Kampi/LoRa-GPS-Tracker/docs/images/Image_Complete.png

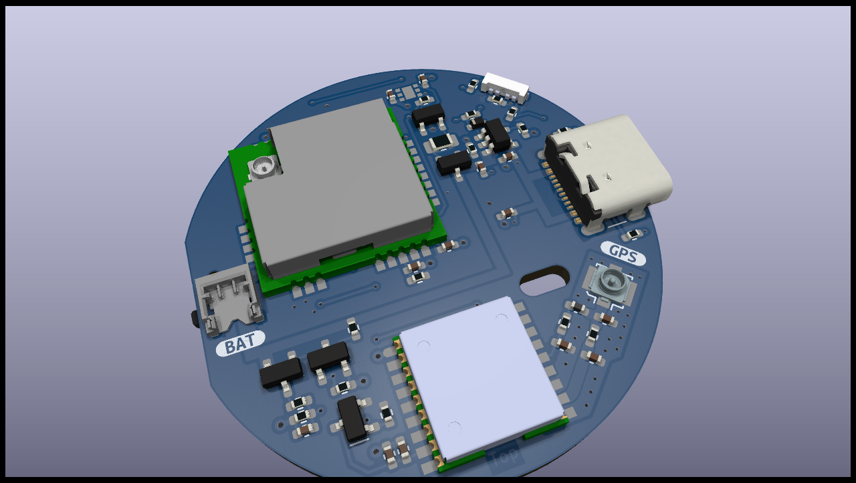
docs/images/Image_Complete.png
