Kampi/LoRa-GPS-Tracker/CHANGELOG.md

# CHANGELOG

## [1.0.0] - 

- Initial release
