Kampi/LoRa-GPS-Tracker/(threads)

Thread 7 (2024-02-12):

Replace micro USB connector with USB C

Kampi, 2024-02-12:

Closed 2024-02-12.
