Kampi/LoRa-GPS-Tracker/project/LoRa-GPS-Tracker.kicad_pcb

## KiCad design project/LoRa-GPS-Tracker.kicad_pcb (2024-10-27)

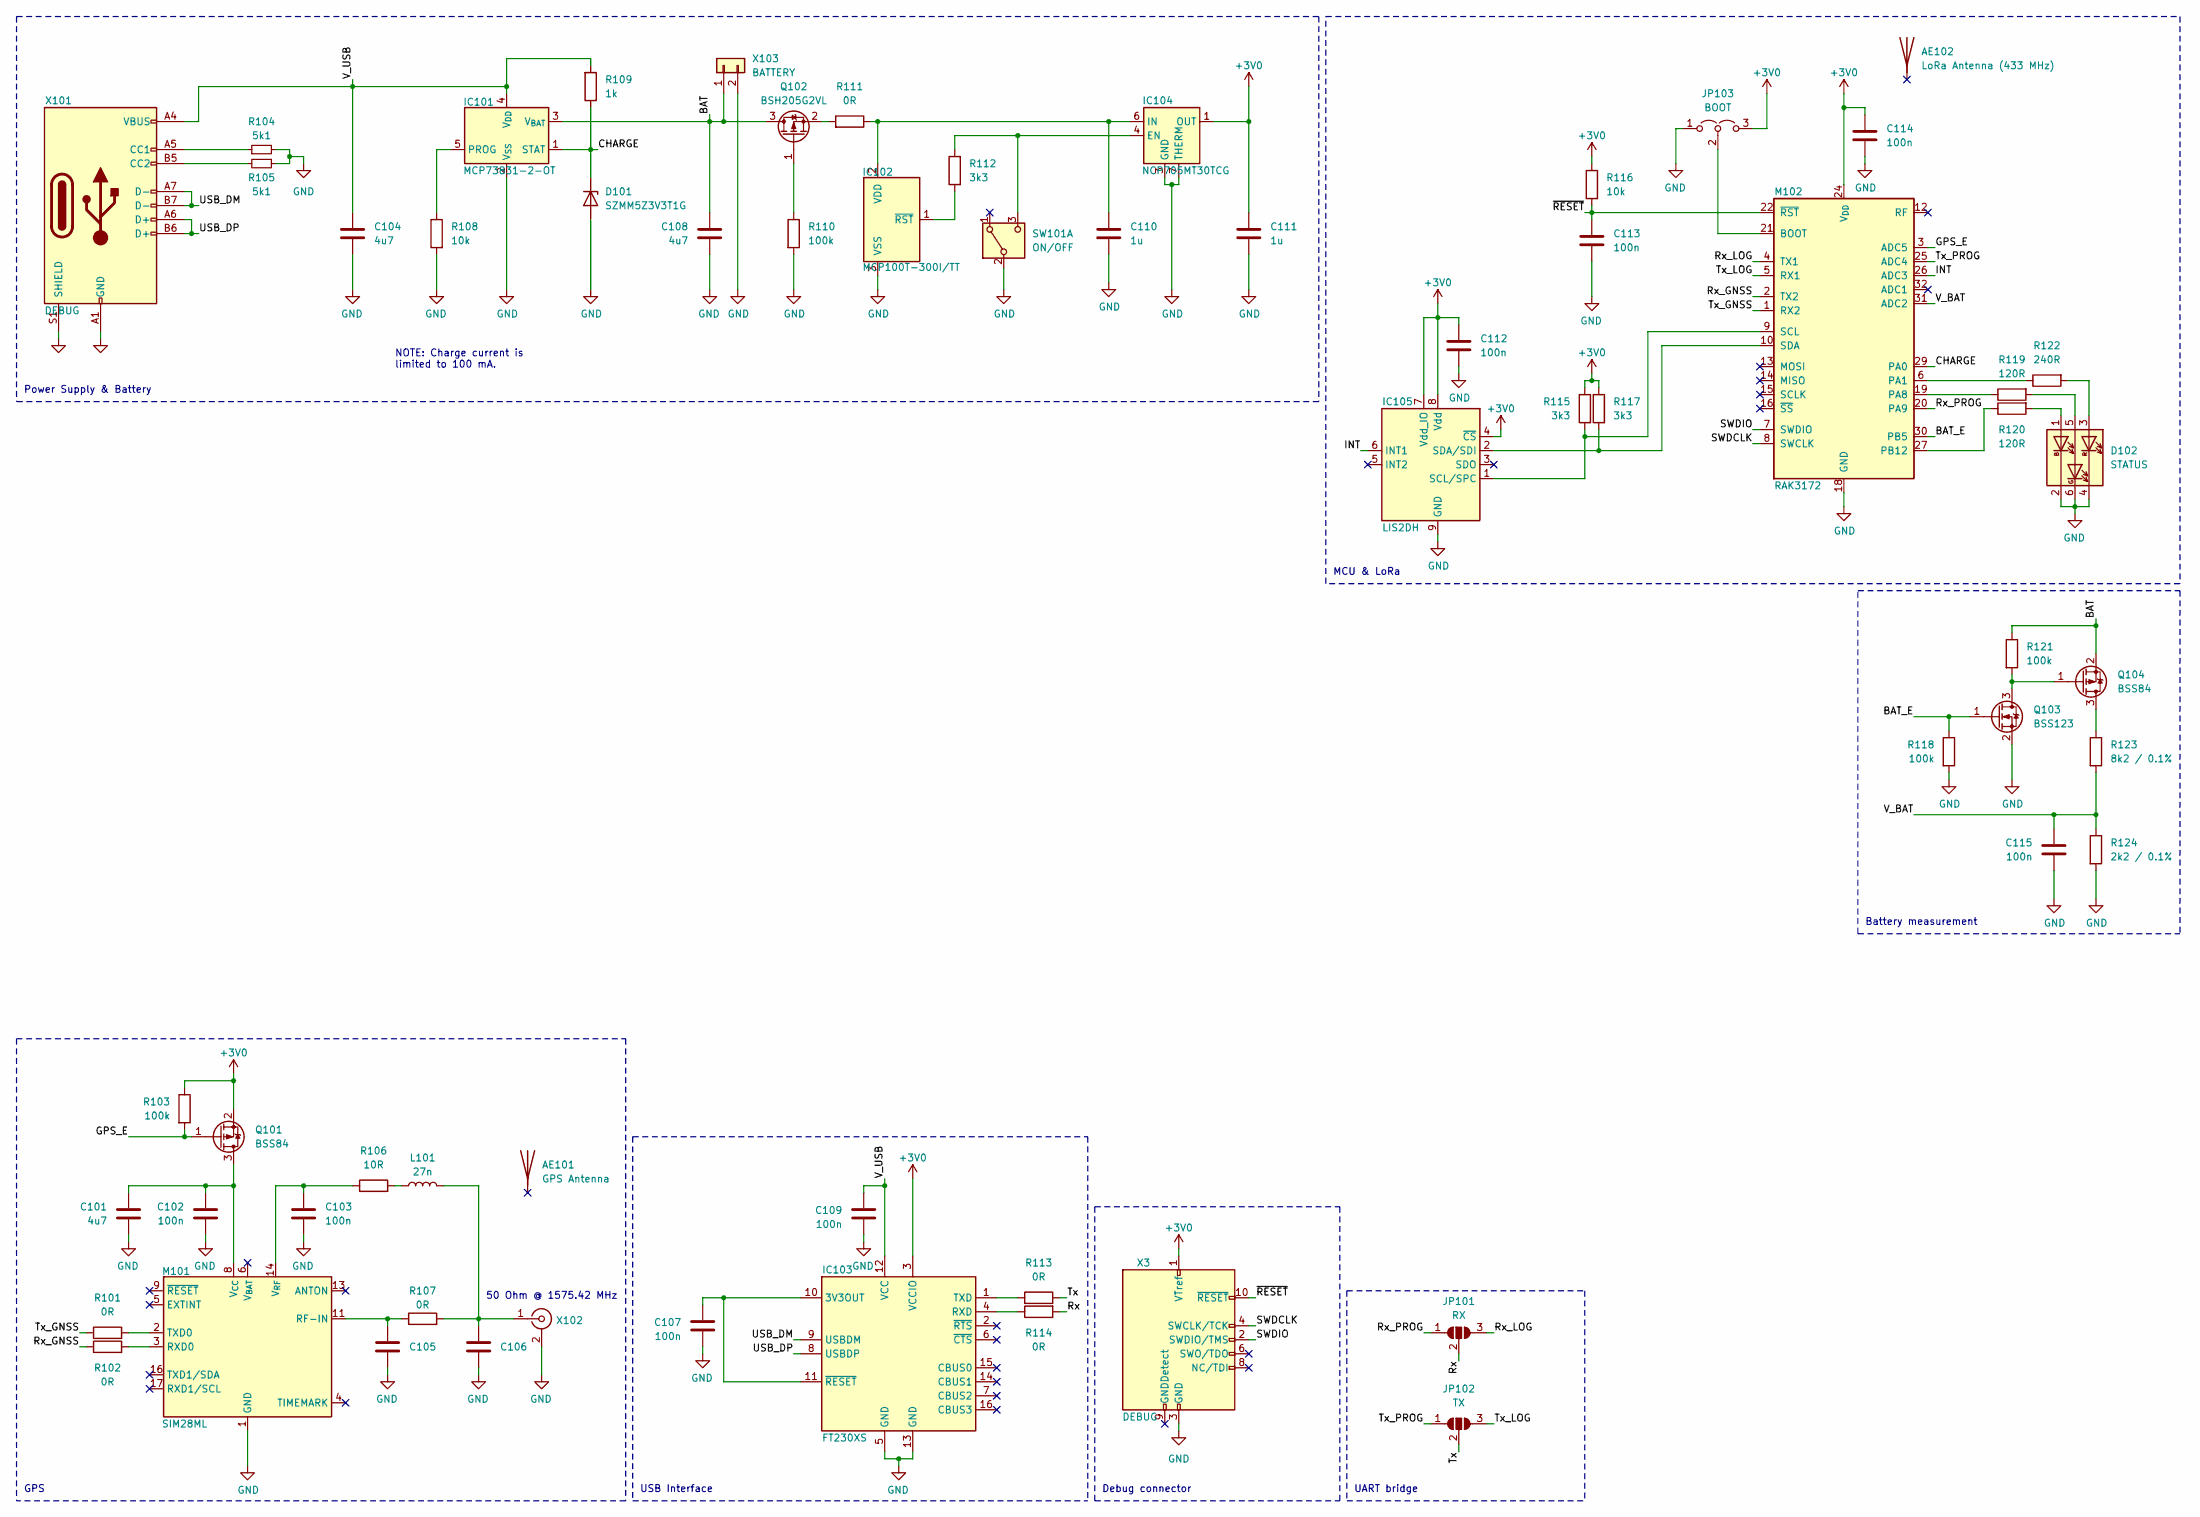
[picture p4: schematic LoRa-GPS-Tracker.kicad_sch]

Parts:
AE101: GPS Antenna
AE102: LoRa Antenna (433 MHz)
C101, C104, C108: 4u7; C_0402_1005Metric_Pad0.74x0.62mm_HandSolder
C102, C103, C107, C109, C112, C113, C114, C115: 100n; C_0402_1005Metric_Pad0.74x0.62mm_HandSolder
C105, C106: C_0402_1005Metric_Pad0.74x0.62mm_HandSolder
C110, C111: 1u; C_0402_1005Metric_Pad0.74x0.62mm_HandSolder
D101: SZMM5Z3V3T1G; D_SOD-523
D102: STATUS; QLS6B-FKW-CNSNSF043
IC101: MCP73831-2-OT; SOT-23-5
IC102: MCP100T-300I/TT; SOT-23
IC103: FT230XS; SSOP-16_3.9x4.9mm_P0.635mm
IC104: NCP705MT30TCG; WDFN-6
IC105: LIS2DH; LGA-14_2x2mm_P0.35mm_LayoutBorder3x4y
JP101: RX; SolderJumper-3_P1.3mm_Open_RoundedPad1.0x1.5mm_NumberLabels
JP102: TX; SolderJumper-3_P1.3mm_Open_RoundedPad1.0x1.5mm_NumberLabels
JP103: BOOT; SolderJumper-3_P1.3mm_Open_RoundedPad1.0x1.5mm_NumberLabels
L101: 27n; L_0402_1005Metric_Pad0.77x0.64mm_HandSolder
M101: SIM28ML
M102: RAK3172
Q101, Q104: BSS84; SOT-23
Q102: BSH205G2VL; SOT-23
Q103: BSS123; SOT-23
R101, R102, R107, R113, R114: 0R; R_0402_1005Metric_Pad0.72x0.64mm_HandSolder
R103, R110, R118, R121: 100k; R_0402_1005Metric_Pad0.72x0.64mm_HandSolder
R104, R105: 5k1; R_0402_1005Metric_Pad0.72x0.64mm_HandSolder
R106: 10R; R_0402_1005Metric_Pad0.72x0.64mm_HandSolder
R108, R116: 10k; R_0402_1005Metric_Pad0.72x0.64mm_HandSolder
R109: 1k; R_0402_1005Metric_Pad0.72x0.64mm_HandSolder
R111: 0R; R_0805_2012Metric_Pad1.20x1.40mm_HandSolder
R112, R115, R117: 3k3; R_0402_1005Metric_Pad0.72x0.64mm_HandSolder
R119, R120: 120R; R_0402_1005Metric_Pad0.72x0.64mm_HandSolder
R122: 240R; R_0402_1005Metric_Pad0.72x0.64mm_HandSolder
R123: 8k2 / 0.1%; R_0402_1005Metric_Pad0.72x0.64mm_HandSolder
R124: 2k2 / 0.1%; R_0402_1005Metric_Pad0.72x0.64mm_HandSolder
SW101: ON/OFF; SW_SPDT_PCM12
X3: DEBUG; SHF-105-01-L-D-SM-TR
X101: DEBUG; USB_C_Receptacle_GCT_USB4105-xx-A_16P_TopMnt_Horizontal
X102: Conn_Coaxial; 73412-0110
X103: BATTERY; 78171-0002

Connections:
+3V0: C111.1, C112.1, C114.1, IC103.3 (VCCIO), IC104.1 (OUT), IC105.4 (~CS), IC105.7 (Vdd_IO), IC105.8 (Vdd), JP103.3 (B), M102.24 (VDD), Q101.2 (S), R103.1, R115.1, R116.1, R117.1; also elsewhere on the board
/BAT: C108.1, IC101.3 (V_{BAT}), Q102.3 (D), Q104.2 (S), R121.1, X103.1
/BAT_E: M102.30 (PB5), Q103.1 (G), R118.1
/CHARGE: D101.1 (K), IC101.1 (STAT), M102.29 (PA0), R109.1
/GPS_E: M102.3 (ADC5), Q101.1 (G), R103.2
/INT: IC105.6 (INT1), M102.26 (ADC3)
/Rx: JP101.2 (C), R114.2
/Rx_GNSS: M102.2 (TX2), R102.1
/Rx_LOG: JP101.3 (B), M102.4 (TX1)
/Rx_PROG: JP101.1 (A), M102.20 (PA9)
/SWDCLK: M102.8 (SWCLK); also elsewhere on the board
/SWDIO: M102.7 (SWDIO); also elsewhere on the board
/Tx: JP102.2 (C), R113.1
/Tx_GNSS: M102.1 (RX2), R101.1
/Tx_LOG: JP102.3 (B), M102.5 (RX1)
/Tx_PROG: JP102.1 (A), M102.25 (ADC4)
/USB_DM: IC103.9 (USBDM), X101.A7 (D-), X101.B7 (D-)
/USB_DP: IC103.8 (USBDP), X101.A6 (D+), X101.B6 (D+)
/V_BAT: C115.1, M102.31 (ADC1), R123.2, R124.1
/V_USB: C104.1, C109.1, IC101.4 (V_{DD}), IC103.12 (VCC), R109.2, X101.A4 (VBUS), X101.A9 (VBUS), X101.B4 (VBUS), X101.B9 (VBUS)
/~RESET: C113.1, M102.22 (~RST), R116.2; also elsewhere on the board
GND: C101.2, C102.2, C103.2, C104.2, C105.2, C106.2, C107.2, C108.2, C109.2, C110.2, C111.2, C112.2, C113.2, C114.2, C115.2, D101.2 (A), D102.2 (KB), D102.4 (KR), D102.6 (KR), IC101.2 (V_{SS}), IC102.3 (VSS), IC103.5 (GND), IC103.13 (GND), IC104.3 (GND), IC104.7 (THERM), IC105.9 (GND), IC105.10 (GND), IC105.11 (GND), IC105.12 (GND), IC105.13 (GND), IC105.14 (GND), JP103.1 (A), M101.1 (GND), M101.10 (GND), M101.12 (GND), M102.11 (VSS), M102.17 (VSS), M102.18 (VSS), M102.23 (VSS), M102.28 (VSS), Q103.2 (S), R104.2, R105.1, R108.2, R110.2, R118.2, R124.2, SW101.2 (B), X101.A1 (GND), X101.A12 (GND), X101.B1 (GND), X101.B12 (GND), X101.S1 (SHIELD), X102.2 (Ext), X103.2; also elsewhere on the board
unnamed: D102.1 (AB), R120.2
unnamed: D102.5 (AG), R119.2
unnamed: D102.3 (AR), R122.2
unnamed: IC101.5 (PROG), R108.1
unnamed: C110.1, IC102.2 (VDD), IC104.6 (IN), R111.1
unnamed: IC102.1 (~RST), R112.2
unnamed: C107.1, IC103.10 (3V3OUT), IC103.11 (~RESET)
unnamed: IC103.4 (RXD), R114.1
unnamed: IC103.1 (TXD), R113.2
unnamed: IC104.4 (EN), R112.1, SW101.3 (C)
unnamed: IC105.1 (SCL/SPC), M102.9 (SCL), R115.2
unnamed: IC105.2 (SDA/SDI), M102.10 (SDA), R117.2
unnamed: JP103.2 (C), M102.21 (BOOT)
unnamed: L101.1, R106.2
unnamed: C105.1, M101.11 (RF_IN), R107.1
unnamed: M101.3 (RXD0), R102.2
unnamed: M101.2 (TXD0), R101.2
unnamed: C101.1, C102.1, M101.8 (VCC), Q101.3 (D)
unnamed: C103.1, M101.14 (VCC_RF), R106.1
unnamed: M102.6 (PA1), R122.1
unnamed: M102.19 (PA8), R119.1
unnamed: M102.27 (PB12), R120.1
unnamed: Q102.1 (G), R110.1
unnamed: Q102.2 (S), R111.2
unnamed: Q103.3 (D), Q104.1 (G), R121.2
unnamed: Q104.3 (D), R123.1
unnamed: R104.1, X101.A5 (CC1)
unnamed: R105.2, X101.B5 (CC2)
unnamed: C106.1, L101.2, R107.2, X102.1 (In)

Notes on the sheet:
Debug connector
GPS
USB Interface
UART bridge
50 Ohm @ 1575.42 MHz
Battery measurement
Power Supply & Battery
NOTE: Charge current is limited to 100 mA.
MCU & LoRa

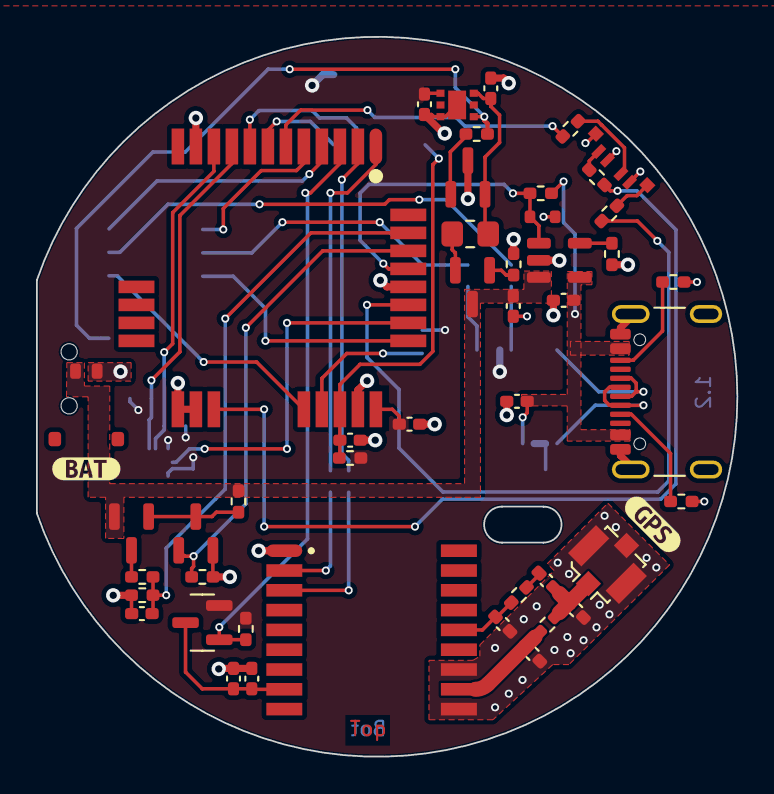
[picture p5: board LoRa-GPS-Tracker.kicad_pcb from above]

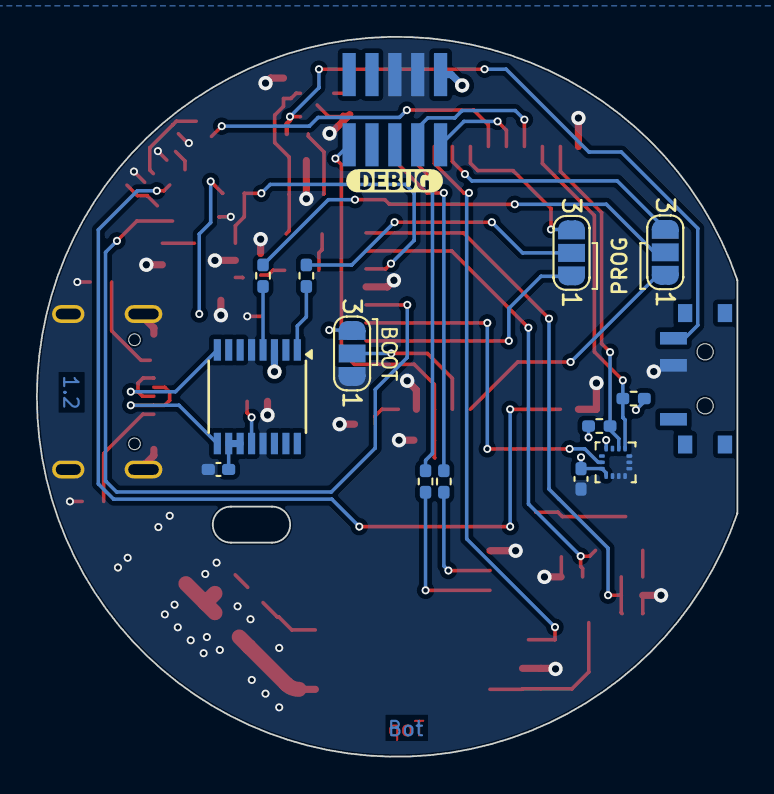
[picture p6: board LoRa-GPS-Tracker.kicad_pcb from below]

Board: 2 copper layers, 38.9 x 40.0 mm, 64 parts (16 on the bottom side), 51 nets.

Other parts of the board:
X104: DEBUG; SHF-105-01-L-D-SM-TR
kibuzzard-65A187C4: G***; kibuzzard-65A187C4
kibuzzard-65A18804: G***; kibuzzard-65A18804
kibuzzard-66008FCD: G***; kibuzzard-66008FCD

Their connections:
+3V0: X104.1 (VTref); also elsewhere on the board
/SWDCLK: X104.4 (SWCLK/TCK); also elsewhere on the board
/SWDIO: X104.2 (SWDIO/TMS); also elsewhere on the board
/~RESET: X104.10 (~RESET); also elsewhere on the board
GND: X104.3 (GND), X104.5 (GND); also elsewhere on the board
