Kampi/LoRa-GPS-Tracker/firmware/LoRa-GPS-Tracker.ioc

Mcu.UserName=STM32WLE5CCUx
PA0.GPIO_Label=CHARGE
PA0.Signal=GPIO_Input
PA1.GPIO_Label=LED3
PA1.Signal=GPIO_Output
PA10.Signal=I2C1_SDA
PA13.Signal=DEBUG_JTMS-SWDIO
PA14.Signal=DEBUG_JTCK-SWCLK
PA15.GPIO_Label=GPS_E
PA15.Signal=GPIO_Output
PA2.GPIO_Label=GPS_TX
PA2.Signal=LPUART1_TX
PA3.GPIO_Label=GPS_RX
PA3.Signal=LPUART1_RX
PA8.GPIO_Label=LED2
PA8.Signal=GPIO_Output
PA9.Signal=I2C1_SCL
PB12.GPIO_Label=LED1
PB12.Signal=GPIO_Output
PB2.GPIO_Label=INT
PB2.Signal=GPIO_Input
PB3.GPIO_Label=V_BAT
PB3.Signal=ADC_IN2
PB5.GPIO_Label=BAT_E
PB5.Signal=GPIO_Output
PB6.GPIO_Label=SERIAL_TX
PB6.Signal=USART1_TX
PB7.GPIO_Label=SERIAL_RX
PB7.Signal=USART1_RX
PC14-OSC32_IN.Signal=RCC_OSC32_IN
PC15-OSC32_OUT.Signal=RCC_OSC32_OUT
