Kampi/LoRa-GPS-Tracker/firmware/Core/Inc/main.h

#define APRS_CALLSIGN "DO2DKH-1"
#define RTC_PREDIV_A ((1<<(15-RTC_N_PREDIV_S))-1)
#define RTC_N_PREDIV_S 10
#define RTC_PREDIV_S ((1<<RTC_N_PREDIV_S)-1)
#define APRS_DESTINATION "APLG01"
#define V_BAT_Pin GPIO_PIN_3
#define V_BAT_GPIO_Port GPIOB
#define BAT_E_Pin GPIO_PIN_5
#define BAT_E_GPIO_Port GPIOB
#define SERIAL_TX_Pin GPIO_PIN_6
#define SERIAL_TX_GPIO_Port GPIOB
#define SERIAL_RX_Pin GPIO_PIN_7
#define SERIAL_RX_GPIO_Port GPIOB
#define CHARGE_Pin GPIO_PIN_0
#define CHARGE_GPIO_Port GPIOA
#define LED3_Pin GPIO_PIN_1
#define LED3_GPIO_Port GPIOA
#define GPS_TX_Pin GPIO_PIN_2
#define GPS_TX_GPIO_Port GPIOA
#define GPS_RX_Pin GPIO_PIN_3
#define GPS_RX_GPIO_Port GPIOA
#define LED2_Pin GPIO_PIN_8
#define LED2_GPIO_Port GPIOA
#define INT_Pin GPIO_PIN_2
#define INT_GPIO_Port GPIOB
#define LED1_Pin GPIO_PIN_12
#define LED1_GPIO_Port GPIOB
#define GPS_E_Pin GPIO_PIN_15
#define GPS_E_GPIO_Port GPIOA
