Kampi/LoRa-GPS-Tracker/firmware/Core/Src/usart.c

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
/* Includes ------------------------------------------------------------------*/
#include "usart.h"

/* USER CODE BEGIN 0 */
#include <string.h>

#include "sys_app.h"
/* USER CODE END 0 */

UART_HandleTypeDef hlpuart1;
UART_HandleTypeDef huart1;
DMA_HandleTypeDef hdma_usart1_tx;

/* LPUART1 init function */

void MX_LPUART1_UART_Init(void)
{

  hlpuart1.Instance = LPUART1;
  hlpuart1.Init.BaudRate = 9600;
  hlpuart1.Init.WordLength = UART_WORDLENGTH_8B;
  hlpuart1.Init.StopBits = UART_STOPBITS_1;
  hlpuart1.Init.Parity = UART_PARITY_NONE;
  hlpuart1.Init.Mode = UART_MODE_TX_RX;
  hlpuart1.Init.HwFlowCtl = UART_HWCONTROL_NONE;
  hlpuart1.Init.OneBitSampling = UART_ONE_BIT_SAMPLE_DISABLE;
  hlpuart1.Init.ClockPrescaler = UART_PRESCALER_DIV1;
  hlpuart1.AdvancedInit.AdvFeatureInit = UART_ADVFEATURE_RXOVERRUNDISABLE_INIT|UART_ADVFEATURE_DMADISABLEONERROR_INIT;
  hlpuart1.AdvancedInit.OverrunDisable = UART_ADVFEATURE_OVERRUN_DISABLE;
  hlpuart1.AdvancedInit.DMADisableonRxError = UART_ADVFEATURE_DMA_DISABLEONRXERROR;
  hlpuart1.FifoMode = UART_FIFOMODE_DISABLE;
  if (HAL_UART_Init(&hlpuart1) != HAL_OK)
  {
    Error_Handler();
  }
  if (HAL_UARTEx_SetTxFifoThreshold(&hlpuart1, UART_TXFIFO_THRESHOLD_1_8) != HAL_OK)
  {
    Error_Handler();
  }
  if (HAL_UARTEx_SetRxFifoThreshold(&hlpuart1, UART_RXFIFO_THRESHOLD_1_8) != HAL_OK)
  {
    Error_Handler();
  }
  if (HAL_UARTEx_DisableFifoMode(&hlpuart1) != HAL_OK)
  {
    Error_Handler();
  }
}
/* USART1 init function */

void MX_USART1_UART_Init(void)
{

  huart1.Instance = USART1;
  huart1.Init.BaudRate = 115200;
  huart1.Init.WordLength = UART_WORDLENGTH_8B;
  huart1.Init.StopBits = UART_STOPBITS_1;
  huart1.Init.Parity = UART_PARITY_NONE;
  huart1.Init.Mode = UART_MODE_TX_RX;
  huart1.Init.HwFlowCtl = UART_HWCONTROL_NONE;
  huart1.Init.OverSampling = UART_OVERSAMPLING_16;
  huart1.Init.OneBitSampling = UART_ONE_BIT_SAMPLE_DISABLE;
  huart1.Init.ClockPrescaler = UART_PRESCALER_DIV1;
  huart1.AdvancedInit.AdvFeatureInit = UART_ADVFEATURE_NO_INIT;
  if (HAL_UART_Init(&huart1) != HAL_OK)
  {
    Error_Handler();
  }
  if (HAL_UARTEx_SetTxFifoThreshold(&huart1, UART_TXFIFO_THRESHOLD_1_8) != HAL_OK)
  {
    Error_Handler();
  }
  if (HAL_UARTEx_SetRxFifoThreshold(&huart1, UART_RXFIFO_THRESHOLD_1_8) != HAL_OK)
  {
    Error_Handler();
  }
  if (HAL_UARTEx_EnableFifoMode(&huart1) != HAL_OK)
  {
    Error_Handler();
  }
}

void HAL_UART_MspInit(UART_HandleTypeDef* uartHandle)
{

  GPIO_InitTypeDef GPIO_InitStruct = {0};
  RCC_PeriphCLKInitTypeDef PeriphClkInitStruct = {0};
  if(uartHandle->Instance==LPUART1)
  {
  /** Initializes the peripherals clocks
  */
    PeriphClkInitStruct.PeriphClockSelection = RCC_PERIPHCLK_LPUART1;
    PeriphClkInitStruct.Lpuart1ClockSelection = RCC_LPUART1CLKSOURCE_LSE;
    if (HAL_RCCEx_PeriphCLKConfig(&PeriphClkInitStruct) != HAL_OK)
    {
      Error_Handler();
    }

    /* LPUART1 clock enable */
    __HAL_RCC_LPUART1_CLK_ENABLE();

    __HAL_RCC_GPIOA_CLK_ENABLE();
    /**LPUART1 GPIO Configuration
    PA2     ------> LPUART1_TX
    PA3     ------> LPUART1_RX
    */
    GPIO_InitStruct.Pin = GPS_TX_Pin|GPS_RX_Pin;
    GPIO_InitStruct.Mode = GPIO_MODE_AF_PP;
    GPIO_InitStruct.Pull = GPIO_NOPULL;
    GPIO_InitStruct.Speed = GPIO_SPEED_FREQ_LOW;
    GPIO_InitStruct.Alternate = GPIO_AF8_LPUART1;
    HAL_GPIO_Init(GPIOA, &GPIO_InitStruct);

    /* LPUART1 interrupt Init */
    HAL_NVIC_SetPriority(LPUART1_IRQn, 0, 0);
    HAL_NVIC_EnableIRQ(LPUART1_IRQn);
  }
  else if(uartHandle->Instance==USART1)
  {
  /** Initializes the peripherals clocks
  */
    PeriphClkInitStruct.PeriphClockSelection = RCC_PERIPHCLK_USART1;
    PeriphClkInitStruct.Usart1ClockSelection = RCC_USART1CLKSOURCE_SYSCLK;
    if (HAL_RCCEx_PeriphCLKConfig(&PeriphClkInitStruct) != HAL_OK)
    {
      Error_Handler();
    }

    /* USART1 clock enable */
    __HAL_RCC_USART1_CLK_ENABLE();

    __HAL_RCC_GPIOB_CLK_ENABLE();
    /**USART1 GPIO Configuration
    PB6     ------> USART1_TX
    PB7     ------> USART1_RX
    */
    GPIO_InitStruct.Pin = SERIAL_TX_Pin|SERIAL_RX_Pin;
    GPIO_InitStruct.Mode = GPIO_MODE_AF_PP;
    GPIO_InitStruct.Pull = GPIO_NOPULL;
    GPIO_InitStruct.Speed = GPIO_SPEED_FREQ_LOW;
    GPIO_InitStruct.Alternate = GPIO_AF7_USART1;
    HAL_GPIO_Init(GPIOB, &GPIO_InitStruct);

    /* USART1 DMA Init */
    /* USART1_TX Init */
    hdma_usart1_tx.Instance = DMA1_Channel1;
    hdma_usart1_tx.Init.Request = DMA_REQUEST_USART1_TX;
    hdma_usart1_tx.Init.Direction = DMA_MEMORY_TO_PERIPH;
    hdma_usart1_tx.Init.PeriphInc = DMA_PINC_DISABLE;
    hdma_usart1_tx.Init.MemInc = DMA_MINC_ENABLE;
    hdma_usart1_tx.Init.PeriphDataAlignment = DMA_PDATAALIGN_BYTE;
    hdma_usart1_tx.Init.MemDataAlignment = DMA_MDATAALIGN_BYTE;
    hdma_usart1_tx.Init.Mode = DMA_NORMAL;
    hdma_usart1_tx.Init.Priority = DMA_PRIORITY_LOW;
    if (HAL_DMA_Init(&hdma_usart1_tx) != HAL_OK)
    {
      Error_Handler();
    }

    __HAL_LINKDMA(uartHandle,hdmatx,hdma_usart1_tx);

    /* USART1 interrupt Init */
    HAL_NVIC_SetPriority(USART1_IRQn, 0, 0);
    HAL_NVIC_EnableIRQ(USART1_IRQn);
  }
}

void HAL_UART_MspDeInit(UART_HandleTypeDef* uartHandle)
{

  if(uartHandle->Instance==LPUART1)
  {
    /* Peripheral clock disable */
    __HAL_RCC_LPUART1_CLK_DISABLE();

    /**LPUART1 GPIO Configuration
    PA2     ------> LPUART1_TX
    PA3     ------> LPUART1_RX
    */
    HAL_GPIO_DeInit(GPIOA, GPS_TX_Pin|GPS_RX_Pin);

    /* LPUART1 interrupt Deinit */
    HAL_NVIC_DisableIRQ(LPUART1_IRQn);
  }
  else if(uartHandle->Instance==USART1)
  {
    /* Peripheral clock disable */
    __HAL_RCC_USART1_CLK_DISABLE();

    /**USART1 GPIO Configuration
    PB6     ------> USART1_TX
    PB7     ------> USART1_RX
    */
    HAL_GPIO_DeInit(GPIOB, SERIAL_TX_Pin|SERIAL_RX_Pin);

    /* USART1 DMA DeInit */
    HAL_DMA_DeInit(uartHandle->hdmatx);

    /* USART1 interrupt Deinit */
    HAL_NVIC_DisableIRQ(USART1_IRQn);
  }
}

/* USER CODE BEGIN 1 */
int32_t MX_USART1_GPS_Init(void)
{
	const char* PMTK314 = "$PMTK314,0,0,0,1,0,0,0,0,0,0,0,0,0,0,0,0,0,0,0*29\r\n";
	if (MX_USART1_GPS_SendCommand(PMTK314, strlen(PMTK314)) != HAL_OK)
	{
		return HAL_ERROR;
	}

	const char* PMTK225 = "$PMTK225,2,1000,10000,0,0*19\r\n";
	if (MX_USART1_GPS_SendCommand(PMTK225, strlen(PMTK225)) != HAL_OK)
	{
		return HAL_ERROR;
	}

	return HAL_OK;
}

int32_t MX_USART1_GPS_SendCommand(const char* Command, uint16_t Length)
{
	char ReceiveBuffer[256] = {0};
	char* Start;
	char* Token;

	if (HAL_UART_Transmit(&hlpuart1, (const uint8_t*)Command, Length, 100) != HAL_OK)
	{
		return HAL_ERROR;
	}

	do {
		memset(ReceiveBuffer, 0, sizeof(ReceiveBuffer));

		HAL_UART_Receive(&hlpuart1, (uint8_t*)ReceiveBuffer, sizeof(ReceiveBuffer), 100);

		Start = strstr(ReceiveBuffer, "PMTK");
		if (Start != NULL) {
			break;
		}
	} while(1);

  APP_LOG(TS_OFF, VLEVEL_M, "Buffer: %s", Start);

  // Fetch and discard the header
  Token = strtok(Start, ",");
  APP_LOG(TS_OFF, VLEVEL_M, "Header: %s\n\r", Token);
  if (strstr(Token, "PMTK001") != NULL)
  {
  	// PMTK_ACK
  	// Fetch and discard data packet
    strtok(NULL, ",");

    // Fetch the status code and the checksum
    Token = strtok(NULL, ",");
    APP_LOG(TS_OFF, VLEVEL_M, "Flag: %s\n\r", Token);

    if (Token[0] != '3')
    {
      APP_LOG(TS_OFF, VLEVEL_M, "Error\n\r");
    	return HAL_ERROR;
    }
  }
  else if (strstr(Token, "PMTK010") != NULL)
  {
  	// PMTK_SYS_MSG
  }
  else
  {
  	return HAL_ERROR;
  }

	return HAL_OK;
}

void MX_USART1_GPS_Sleep(void)
{
  // Make sure that no LPUART transfer is on-going
  while (__HAL_UART_GET_FLAG(&hlpuart1, USART_ISR_BUSY) == SET);

  // Make sure that LPUART is ready to receive
  while (__HAL_UART_GET_FLAG(&hlpuart1, USART_ISR_REACK) == RESET);

  __HAL_UART_ENABLE_IT(&hlpuart1, UART_IT_WUF);

  HAL_UARTEx_EnableStopMode(&hlpuart1);
}

void MX_USART1_GPS_WakeUp(void)
{
  HAL_UARTEx_DisableStopMode(&hlpuart1);
}

int32_t MX_USART1_GPS_GetNMEA(char* p_LineBuffer, uint32_t Length)
{
	uint8_t Temp;
	uint32_t BytesReceived = 0;

	if (Length == 0)
	{
		return HAL_ERROR;
	}

	memset(p_LineBuffer, 0, Length);

	do
	{
		if (HAL_UART_Receive(&hlpuart1, &Temp, 1, 10) != HAL_OK)
		{
			return HAL_ERROR;
		}

		*p_LineBuffer++ = Temp;
		BytesReceived++;
	} while ((Temp != '\n') || (BytesReceived == Length));

  return HAL_OK;
}
/* USER CODE END 1 */
