Kampi/LoRa-GPS-Tracker/firmware/SubGHz_Phy/App/app_subghz_phy.c

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

/* Includes ------------------------------------------------------------------*/
#include "app_subghz_phy.h"
#include "subghz_phy_app.h"
#include "sys_app.h"
#include "stm32_seq.h"

/* USER CODE BEGIN Includes */
#include "main.h"
#include "usart.h"
#include "rtc.h"
#include "app_version.h"
#include "stm32wlxx_hal_rcc.h"
/* USER CODE END Includes */

/* External variables ---------------------------------------------------------*/
/* USER CODE BEGIN PTD */
typedef struct {
	char utc[11];
	char lat[10];
	char lat_dir[2];
	char lon[11];
	char lon_dir[2];
	uint8_t Quality;
} GPS_GPGGA_t;
/* USER CODE END PTD */

/* USER CODE BEGIN PV */
static char APRS_Destination[] = "APLG01";

static uint8_t APRS_TransmitBuffer[255];
static uint8_t APRS_Header[] = {'<', 0xFF, 0x01};
/* USER CODE END PV */

/* USER CODE BEGIN PFP */
static int32_t MX_SubGHz_Phy_APRS_Send(GPS_GPGGA_t* p_Position, char* p_Challsign, char* p_Message);
static void MX_SubGHz_Phy_EnterSleep(void);
/* USER CODE END PFP */

/* Exported functions --------------------------------------------------------*/

void MX_SubGHz_Phy_Init(void)
{
  /* USER CODE BEGIN MX_SubGHz_Phy_Init_1 */
	uint32_t InitCounter = 1;
  /* USER CODE END MX_SubGHz_Phy_Init_1 */
  SystemApp_Init();
  /* USER CODE BEGIN MX_SubGHz_Phy_Init_1_1 */
  APP_LOG(TS_OFF, VLEVEL_M, "\n\rLoRa GPS Tracker\n\r");

  /* Get SubGHY_Phy APP version*/
  APP_LOG(TS_OFF, VLEVEL_M, "Application version:\tV%X.%X.%X\r\n",
          (uint8_t)(APP_VERSION_MAIN),
          (uint8_t)(APP_VERSION_SUB1),
          (uint8_t)(APP_VERSION_SUB2));
  /* USER CODE END MX_SubGHz_Phy_Init_1_1 */
  SubghzApp_Init();
  /* USER CODE BEGIN MX_SubGHz_Phy_Init_2 */

  // Run the device initialization when a PoR or Pin reset has happened.
  if (__HAL_RCC_GET_FLAG(RCC_FLAG_LPWRRST) || __HAL_RCC_GET_FLAG(RCC_FLAG_PINRST))
  {
    APP_LOG(TS_OFF, VLEVEL_M, "Device reset...\n\r");
/*
    do {
      APP_LOG(TS_OFF, VLEVEL_M, "Initialize GPS module. Attempt %u\n\r", InitCounter);
      InitCounter++;

      if (InitCounter > 10)
      {
      	Error_Handler();
      }
    } while (MX_USART1_GPS_Init() != HAL_OK);
*/
    APP_LOG(TS_OFF, VLEVEL_M, "Initialization successful!\n\r");

    for (uint8_t i = 0; i < 4; i++)
    {
      HAL_GPIO_WritePin(STATUS_GPIO_Port, STATUS_Pin, GPIO_PIN_SET);
      HAL_Delay(100);
      HAL_GPIO_WritePin(STATUS_GPIO_Port, STATUS_Pin, GPIO_PIN_RESET);
      HAL_Delay(100);
    }

    __HAL_RCC_CLEAR_RESET_FLAGS();
  }
  else
  {
  	APP_LOG(TS_OFF, VLEVEL_M, "Wake up\n\r");
    MX_USART1_GPS_WakeUp();
  }

  /* USER CODE END MX_SubGHz_Phy_Init_2 */
}

void MX_SubGHz_Phy_Process(void)
{
  /* USER CODE BEGIN MX_SubGHz_Phy_Process_1 */
	int32_t Status;
	char LineBuffer[128];
	GPS_GPGGA_t GPGGA_Data;

	memset(&GPGGA_Data, 0, sizeof(GPGGA_Data));

	Status = MX_USART1_GPS_GetNMEA(LineBuffer, sizeof(LineBuffer));
	if (Status == HAL_OK)
	{
	  APP_LOG(TS_OFF, VLEVEL_M, "Message: %s\n\r", LineBuffer);

	  // Format: $GPGGA,174857.000,4932.1285,N,01046.6422,E,2,9,0.90,388.3,M,47.9,M,,*5E
	  if (strstr(LineBuffer, "$GPGGA") != NULL)
	  {
	  	char* Token;

		  // Fetch and discard the header
		  strtok(LineBuffer, ",");

		  Token = strtok(NULL, ",");
		  memcpy(&GPGGA_Data.utc, Token, strlen(Token));
		  Token = strtok(NULL, ",");
		  memcpy(&GPGGA_Data.lat, Token, strlen(Token));
		  Token = strtok(NULL, ",");
		  memcpy(&GPGGA_Data.lat_dir, Token, strlen(Token));
		  Token = strtok(NULL, ",");
		  memcpy(&GPGGA_Data.lon, Token, strlen(Token));
		  Token = strtok(NULL, ",");
		  memcpy(&GPGGA_Data.lon_dir, Token, strlen(Token));

		  APP_LOG(TS_OFF, VLEVEL_M, "\tUTC: %s\n\r", GPGGA_Data.utc);
		  APP_LOG(TS_OFF, VLEVEL_M, "\tLatitude: %s\n\r", GPGGA_Data.lat);
		  APP_LOG(TS_OFF, VLEVEL_M, "\tLatitude direction: %s\n\r", GPGGA_Data.lat_dir);
		  APP_LOG(TS_OFF, VLEVEL_M, "\tLongitude: %s\n\r", GPGGA_Data.lon);
		  APP_LOG(TS_OFF, VLEVEL_M, "\tLongitude direction: %s\n\r", GPGGA_Data.lon_dir);
		  MX_SubGHz_Phy_APRS_Send(&GPGGA_Data, APRS_CALLSIGN, "Test123");
		  HAL_Delay(100);

		  MX_SubGHz_Phy_EnterSleep();
	  }
	}

  /* USER CODE END MX_SubGHz_Phy_Process_1 */
  UTIL_SEQ_Run(UTIL_SEQ_DEFAULT);
}

/* USER CODE BEGIN PrFD */

void MX_SubGHz_Phy_EnterSleep(void)
{
  UART_WakeUpTypeDef WakeUpSelection;

  SubghzApp_Sleep();

  MX_USART1_GPS_Sleep();

  // Set the wake-up event
  WakeUpSelection.WakeUpEvent = UART_WAKEUP_ON_READDATA_NONEMPTY;
  if (HAL_UARTEx_StopModeWakeUpSourceConfig(&hlpuart1, WakeUpSelection) != HAL_OK)
  {
    Error_Handler();
  }

  HAL_PWR_EnterSTOPMode(PWR_LOWPOWERREGULATOR_ON, PWR_STOPENTRY_WFI);
}

int32_t MX_SubGHz_Phy_APRS_Send(GPS_GPGGA_t* p_Position, char* p_Challsign, char* p_Message)
{
	uint8_t TotalLength = 0;

	memcpy(&APRS_TransmitBuffer[TotalLength], APRS_Header, sizeof(APRS_Header));
	TotalLength += sizeof(APRS_Header);

	memcpy(&APRS_TransmitBuffer[TotalLength], p_Challsign, strlen(p_Challsign));
	TotalLength += strlen(p_Challsign);

	APRS_TransmitBuffer[TotalLength] = '>';
	TotalLength += 1;

	memcpy(&APRS_TransmitBuffer[TotalLength], APRS_Destination, strlen(APRS_Destination));
	TotalLength += strlen(APRS_Destination);

	APRS_TransmitBuffer[TotalLength] = ':';
	TotalLength += 1;

	APRS_TransmitBuffer[TotalLength] = '!';
	TotalLength += 1;

	memcpy(&APRS_TransmitBuffer[TotalLength], p_Position->lat, 7);
	TotalLength += 7;

	memcpy(&APRS_TransmitBuffer[TotalLength], p_Position->lat_dir, 1);
	TotalLength += 1;

	memcpy(&APRS_TransmitBuffer[TotalLength], p_Position->lon, 8);
	TotalLength += 8;

	memcpy(&APRS_TransmitBuffer[TotalLength], p_Position->lon_dir, 1);
	TotalLength += 1;

	if (p_Message != NULL)
	{
		APRS_TransmitBuffer[TotalLength] = '&';
		TotalLength += 1;

		memcpy(&APRS_TransmitBuffer[TotalLength], p_Message, strlen(p_Message));
		TotalLength += strlen(p_Message);
	}

	return SubghzApp_Transmit(APRS_TransmitBuffer, TotalLength);
}
/* USER CODE END PrFD */
