Kampi/LoRa-GPS-Tracker/firmware/SubGHz_Phy/App/subghz_phy_app.c

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

/* Includes ------------------------------------------------------------------*/
#include "platform.h"
#include "sys_app.h"
#include "subghz_phy_app.h"
#include "radio.h"

/* USER CODE BEGIN Includes */
#include "stm32_seq.h"
#include "stm32_timer.h"
#include "utilities_def.h"
#include "subghz_phy_version.h"
/* USER CODE END Includes */

/* External variables ---------------------------------------------------------*/
/* USER CODE BEGIN PD */
#define MAX_APP_BUFFER_SIZE          255
/* USER CODE END PD */

/* Radio events function pointer */
static RadioEvents_t RadioEvents;

/* USER CODE BEGIN PV */
static bool TxDone;
/* USER CODE END PV */

/*!
 * @brief Function to be executed on Radio Tx Done event
 */
static void OnTxDone(void);

/**
  * @brief Function to be executed on Radio Rx Done event
  * @param  payload ptr of buffer received
  * @param  size buffer size
  * @param  rssi
  * @param  LoraSnr_FskCfo
  */
static void OnRxDone(uint8_t *payload, uint16_t size, int16_t rssi, int8_t LoraSnr_FskCfo);

/**
  * @brief Function executed on Radio Tx Timeout event
  */
static void OnTxTimeout(void);

/**
  * @brief Function executed on Radio Rx Timeout event
  */
static void OnRxTimeout(void);

/**
  * @brief Function executed on Radio Rx Error event
  */
static void OnRxError(void);

/* Exported functions ---------------------------------------------------------*/
void SubghzApp_Init(void)
{
  /* USER CODE BEGIN SubghzApp_Init_1 */
  /* Get MW SubGhz_Phy info */
  APP_LOG(TS_OFF, VLEVEL_M, "Radio version:\tV%X.%X.%X\r\n",
          (uint8_t)(SUBGHZ_PHY_VERSION_MAIN),
          (uint8_t)(SUBGHZ_PHY_VERSION_SUB1),
          (uint8_t)(SUBGHZ_PHY_VERSION_SUB2));
  /* USER CODE END SubghzApp_Init_1 */

  /* Radio initialization */
  RadioEvents.TxDone = OnTxDone;
  RadioEvents.RxDone = OnRxDone;
  RadioEvents.TxTimeout = OnTxTimeout;
  RadioEvents.RxTimeout = OnRxTimeout;
  RadioEvents.RxError = OnRxError;

  Radio.Init(&RadioEvents);

  /* USER CODE BEGIN SubghzApp_Init_2 */
  /* Radio Set frequency */
  Radio.SetChannel(RF_FREQUENCY);

  /* Radio configuration */
  APP_LOG(TS_OFF, VLEVEL_M, "\n\r");
  APP_LOG(TS_OFF, VLEVEL_M, "Radio settings\n\r");
  APP_LOG(TS_OFF, VLEVEL_M, "\tLoRa Bandwidth: %d kHz\n\r", (1 << LORA_BANDWIDTH) * 125);
  APP_LOG(TS_OFF, VLEVEL_M, "\tLoRa Spreading factor: %d\n\r", LORA_SPREADING_FACTOR);
  APP_LOG(TS_OFF, VLEVEL_M, "\tLoRa Frequency: %d\n\r", RF_FREQUENCY);

  Radio.SetTxConfig(MODEM_LORA, TX_OUTPUT_POWER, 0, LORA_BANDWIDTH,
                    LORA_SPREADING_FACTOR, LORA_CODINGRATE,
                    LORA_PREAMBLE_LENGTH, LORA_FIX_LENGTH_PAYLOAD_ON,
                    true, 0, 0, LORA_IQ_INVERSION_ON, 3000);

  Radio.SetRxConfig(MODEM_LORA, LORA_BANDWIDTH, LORA_SPREADING_FACTOR,
                    LORA_CODINGRATE, 0, LORA_PREAMBLE_LENGTH,
                    LORA_SYMBOL_TIMEOUT, LORA_FIX_LENGTH_PAYLOAD_ON,
                    0, true, 0, 0, LORA_IQ_INVERSION_ON, true);

  Radio.SetMaxPayloadLength(MODEM_LORA, MAX_APP_BUFFER_SIZE);
  Radio.Sleep();
  /* USER CODE END SubghzApp_Init_2 */
}

/* USER CODE BEGIN EF */
int32_t SubghzApp_Transmit(const uint8_t* p_Buffer, uint8_t Length)
{
	if (Length > MAX_APP_BUFFER_SIZE)
	{
		return -1;
	}

	TxDone = false;
	if (Radio.Send((uint8_t*)p_Buffer, Length) != RADIO_STATUS_OK)
	{
		return -1;
	}

	while (TxDone == false);

	return 0;
}

void SubghzApp_Sleep(void)
{
	Radio.Sleep();
}

/* USER CODE END EF */

static void OnTxDone(void)
{
  /* USER CODE BEGIN OnTxDone */
  APP_LOG(TS_ON, VLEVEL_L, "OnTxDone\n\r");
  TxDone = true;
  /* USER CODE END OnTxDone */
}

static void OnRxDone(uint8_t *payload, uint16_t size, int16_t rssi, int8_t LoraSnr_FskCfo)
{
  /* USER CODE BEGIN OnRxDone */
  APP_LOG(TS_ON, VLEVEL_L, "OnRxDone\n\r");
  /* USER CODE END OnRxDone */
}

static void OnTxTimeout(void)
{
  /* USER CODE BEGIN OnTxTimeout */
  APP_LOG(TS_ON, VLEVEL_L, "OnTxTimeout\n\r");
  /* USER CODE END OnTxTimeout */
}

static void OnRxTimeout(void)
{
  /* USER CODE BEGIN OnRxTimeout */
  APP_LOG(TS_ON, VLEVEL_L, "OnRxTimeout\n\r");
  /* USER CODE END OnRxTimeout */
}

static void OnRxError(void)
{
  /* USER CODE BEGIN OnRxError */
  APP_LOG(TS_ON, VLEVEL_L, "OnRxError\n\r");
  /* USER CODE END OnRxError */
}
