Kampi/LoRa-GPS-Tracker/testing/Nucleo/Core/Src/gpio.c

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

/* Includes ------------------------------------------------------------------*/
#include "gpio.h"

/*----------------------------------------------------------------------------*/
/* Configure GPIO                                                             */
/*----------------------------------------------------------------------------*/
/** Configure pins as
        * Analog
        * Input
        * Output
        * EVENT_OUT
        * EXTI
        * Free pins are configured automatically as Analog (this feature is enabled through
        * the Code Generation settings)
*/
void MX_GPIO_Init(void)
{

  GPIO_InitTypeDef GPIO_InitStruct = {0};

  /* GPIO Ports Clock Enable */
  __HAL_RCC_GPIOA_CLK_ENABLE();
  __HAL_RCC_GPIOB_CLK_ENABLE();
  __HAL_RCC_GPIOC_CLK_ENABLE();
  __HAL_RCC_GPIOH_CLK_ENABLE();

  /*Configure GPIO pin Output Level */
  HAL_GPIO_WritePin(GPIOB, LED1_Pin|LED2_Pin|LED3_Pin, GPIO_PIN_RESET);

  /*Configure GPIO pins : PA12 PA15 PA11 PA10
                           PA0 PA9 PA6 PA1
                           PA7 PA4 PA5 PA8 */
  GPIO_InitStruct.Pin = GPIO_PIN_12|GPIO_PIN_15|GPIO_PIN_11|GPIO_PIN_10
                          |GPIO_PIN_0|GPIO_PIN_9|GPIO_PIN_6|GPIO_PIN_1
                          |GPIO_PIN_7|GPIO_PIN_4|GPIO_PIN_5|GPIO_PIN_8;
  GPIO_InitStruct.Mode = GPIO_MODE_ANALOG;
  GPIO_InitStruct.Pull = GPIO_NOPULL;
  HAL_GPIO_Init(GPIOA, &GPIO_InitStruct);

  /*Configure GPIO pins : PBPin PBPin PBPin */
  GPIO_InitStruct.Pin = LED1_Pin|LED2_Pin|LED3_Pin;
  GPIO_InitStruct.Mode = GPIO_MODE_OUTPUT_PP;
  GPIO_InitStruct.Pull = GPIO_NOPULL;
  GPIO_InitStruct.Speed = GPIO_SPEED_FREQ_LOW;
  HAL_GPIO_Init(GPIOB, &GPIO_InitStruct);

  /*Configure GPIO pins : PB3 PB4 PB7 PB14
                           PB5 PB8 PB13 PB2
                           PB6 PB12 PB1 PB0
                           PB10 */
  GPIO_InitStruct.Pin = GPIO_PIN_3|GPIO_PIN_4|GPIO_PIN_7|GPIO_PIN_14
                          |GPIO_PIN_5|GPIO_PIN_8|GPIO_PIN_13|GPIO_PIN_2
                          |GPIO_PIN_6|GPIO_PIN_12|GPIO_PIN_1|GPIO_PIN_0
                          |GPIO_PIN_10;
  GPIO_InitStruct.Mode = GPIO_MODE_ANALOG;
  GPIO_InitStruct.Pull = GPIO_NOPULL;
  HAL_GPIO_Init(GPIOB, &GPIO_InitStruct);

  /*Configure GPIO pins : PC13 PC2 PC6 */
  GPIO_InitStruct.Pin = GPIO_PIN_13|GPIO_PIN_2|GPIO_PIN_6;
  GPIO_InitStruct.Mode = GPIO_MODE_ANALOG;
  GPIO_InitStruct.Pull = GPIO_NOPULL;
  HAL_GPIO_Init(GPIOC, &GPIO_InitStruct);

  /*Configure GPIO pin : PH3 */
  GPIO_InitStruct.Pin = GPIO_PIN_3;
  GPIO_InitStruct.Mode = GPIO_MODE_ANALOG;
  GPIO_InitStruct.Pull = GPIO_NOPULL;
  HAL_GPIO_Init(GPIOH, &GPIO_InitStruct);

}

/* USER CODE BEGIN 2 */
void MX_GPIO_GreenFlash(void)
{
	HAL_GPIO_WritePin(LED1_GPIO_Port, LED1_Pin, GPIO_PIN_RESET);
	HAL_GPIO_WritePin(LED2_GPIO_Port, LED2_Pin, GPIO_PIN_RESET);
	HAL_GPIO_WritePin(LED3_GPIO_Port, LED3_Pin, GPIO_PIN_RESET);

	for (uint8_t i = 0; i < 2; i++)
	{
		HAL_GPIO_WritePin(LED2_GPIO_Port, LED2_Pin, GPIO_PIN_SET);
		HAL_Delay(100);
		HAL_GPIO_WritePin(LED2_GPIO_Port, LED2_Pin, GPIO_PIN_RESET);
		HAL_Delay(100);
	}
}

void MX_GPIO_RedFlash(uint8_t cycles)
{
	HAL_GPIO_WritePin(LED1_GPIO_Port, LED1_Pin, GPIO_PIN_RESET);
	HAL_GPIO_WritePin(LED2_GPIO_Port, LED2_Pin, GPIO_PIN_RESET);
	HAL_GPIO_WritePin(LED3_GPIO_Port, LED3_Pin, GPIO_PIN_RESET);

	for (uint8_t i = 0; i < cycles; i++)
	{
		HAL_GPIO_WritePin(LED3_GPIO_Port, LED3_Pin, GPIO_PIN_SET);
		HAL_Delay(100);
		HAL_GPIO_WritePin(LED3_GPIO_Port, LED3_Pin, GPIO_PIN_RESET);
		HAL_Delay(100);
	}
}
/* USER CODE END 2 */
