Kampi/LoRa-GPS-Tracker/(commit log)

2024-01-06 Add KiCad project
    [LoRa-GPS-Tracker.kicad_pcb, LoRa-GPS-Tracker.kicad_sch]
2024-01-07 Version 1
    PCB:
    - Update build.yaml
    - Add PCB variant for KiBot
    [LoRa-GPS-Tracker.kicad_pcb, LoRa-GPS-Tracker.kicad_sch]
2024-01-07 Add LoRa APRS iGate project for 868 MHz
    [configuration.h]
2024-01-07 Add initial APRS demo for Nucleo board
2024-01-07 Version 1.0
    - Add UART GPS parser
    - SubGHz PHY is now using the coordinates from GPS
2024-01-11 Version 1.0
    Electronics:
    - Add jumper for current measurement
    - Add jumper to set the RAK module into bootloader mode
    - Add capacitor for battery measurement
    Testing Firmware:
    Firmware:
    - Add STM32CubeMX project
    Misc:
    - Add README
    - Add CHANGELOG
    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
    [LoRa-GPS-Tracker.kicad_pcb, LoRa-GPS-Tracker.kicad_sch]
2024-01-12 Working on version 1:
    Hardware:
    - Fix empty ZIP files in KiBot template
    - Fix missing drill files in KiBot template
    - Add optional SWD connector for debugging
    - Add minimal variant without UART console and SWD connector
    Nucleo Demo:
    - Adding Standby mode and wakeup by UART
    - Set internal oscillator frequency to 32 MHz to match the external crystal
    [LoRa-GPS-Tracker.kicad_pcb, LoRa-GPS-Tracker.kicad_sch]
2024-01-13 Update build.yml
    Add variants to build.yml
    [LoRa-GPS-Tracker.kicad_pcb, LoRa-GPS-Tracker.kicad_sch]
2024-01-14 Working on version 1
    - Finalize PCB
    - Replace expensive components with cheaper ones
    - Add GPS antenna
    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
    [LoRa-GPS-Tracker.kicad_pcb, LoRa-GPS-Tracker.kicad_sch]
2024-02-07 Working on version 1
    Firmware Testing:
    - Add GPS configuration
    - Add STOP mode sleep
    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
    [LoRa-GPS-Tracker.kicad_pcb]
2024-02-11 Hardware: - Add RESET line for SWD interface - Replace micro USB with USB C
    Software:
    - Add firmware for LoRa-GPS-Tracker PCB
    [LoRa-GPS-Tracker.kicad_pcb, LoRa-GPS-Tracker.kicad_sch]
2024-04-19 - Upgrade KiBot to support KiCad 8
    [LoRa-GPS-Tracker.kicad_pcb, LoRa-GPS-Tracker.kicad_sch]
2024-04-28 - Fix wrong pinout for UART bootloader - Update documentation for bootloader
    [LoRa-GPS-Tracker.kicad_pcb, LoRa-GPS-Tracker.kicad_sch]
2024-10-05 Fix GPS code for Nucleo
    [Nucleo.ioc, app_subghz_phy.c, usart.c, usart.h]
2024-10-05 Add missing part numbers and datasheets
    [LoRa-GPS-Tracker.kicad_sch]
2024-10-06 Make it possible to power cycle the GPS module
    [LoRa-GPS-Tracker.kicad_pcb, LoRa-GPS-Tracker.kicad_sch]
2024-10-22 Add I2C accelerometer
    [LoRa-GPS-Tracker.kicad_pcb, LoRa-GPS-Tracker.kicad_sch]
2024-10-26 Fix wrong package for CC resistors
    [LoRa-GPS-Tracker.kicad_pcb, LoRa-GPS-Tracker.kicad_sch]
2024-10-27 Fix wrong footprint for status LED
    [LoRa-GPS-Tracker.kicad_pcb, LoRa-GPS-Tracker.kicad_sch]
