Kampi/LoRa-GPS-Tracker/(notices)

Notices in the files:
testing/Nucleo/Core/Inc/sys_conf.h:
Copyright (c) 2021 STMicroelectronics.
All rights reserved.
This software is licensed under terms that can be found in the LICENSE file
firmware/Core/Inc/main.h:
Copyright (c) 2024 STMicroelectronics.
firmware/SubGHz_Phy/App/app_subghz_phy.c:
Copyright (c) 2024 Daniel Kampert
README.md:
License: GPL 3.0
